MateusCourel/cabo-de-guerra-leds/docs/fotos/tela-go.jpeg

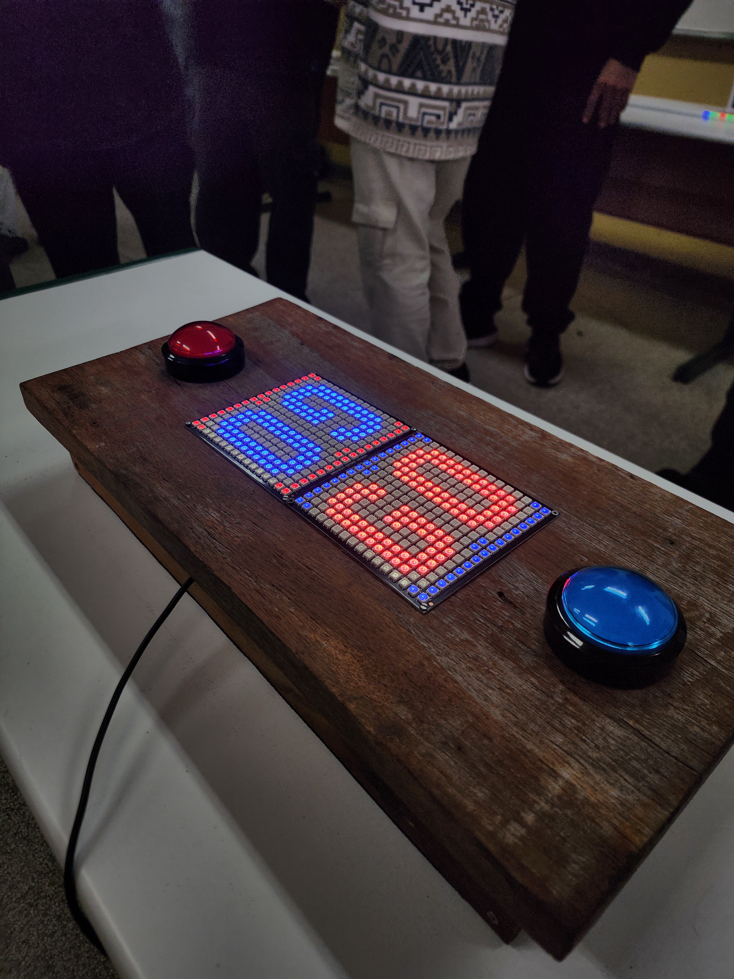
[picture p2: docs/fotos/tela-go.jpeg]
docs/fotos/tela-go.jpeg
